0sirys/USAR_Drone_Feature/USAR_Drone_Feature.step

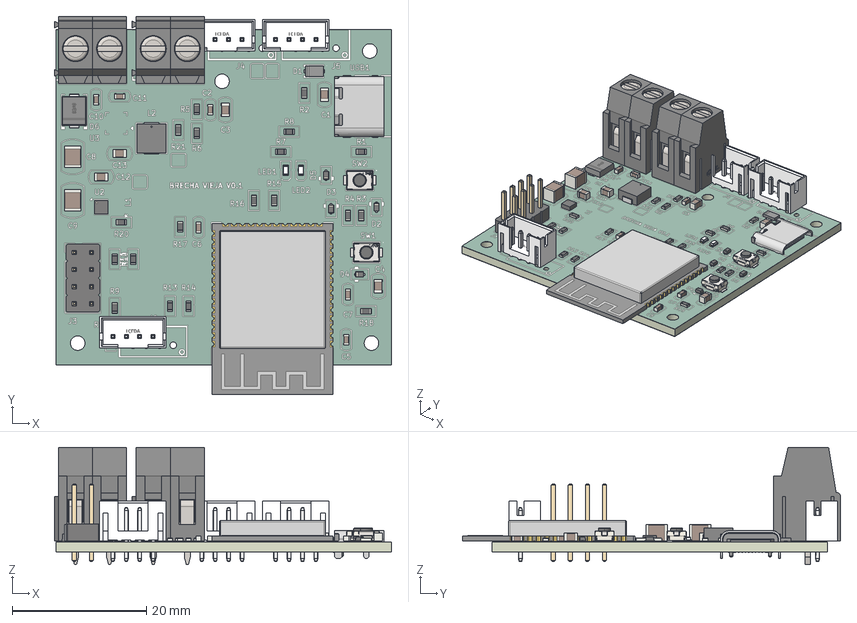
[picture p1: CAD file, 2026-07-15]
USAR_Drone_Feature.step
50.2 x 56.3 x 17.5 mm
CONN-TH_2P-P5.08_DB128L-5.08-2P-BK-S x 2
R_0603_1608Metric x 20
USB-C-SMD_TYPE-C-6PIN-2MD-073
C_1210_3225Metric x 2
C_0805_2012Metric x 5
SMB_L4.32-W3.62-LS5.3-RD
C_0603_1608Metric x 6
SW-SMD_L3.9-W2.9-H2.0-LS4.8 x 2
SOD-123_L2.7-W1.6-LS3.7-FD
PH2.0-LI-4P x 3
WIRELM-SMD_ESP32-S3-WROOM-1
PinHeader_2x04_P254mm_Vertical
LED0603-RD_RED x 2
WSON_8_1EP_2x2mm_P05mm_EP09x16mm
D_SOD_523 x 4
USAR_Drone_Feature_silkscreen
USAR_Drone_Feature_soldermask x 2
USAR_Drone_Feature_PCB
