0sirys/USAR_Drone_Feature/(list of files, cad)

Other CAD files:
.step
