0sirys/USAR_Drone_Feature/USAR_Drone_Feature.kicad_pcb

## KiCad design USAR_Drone_Feature.kicad_pcb (2026-08-30)

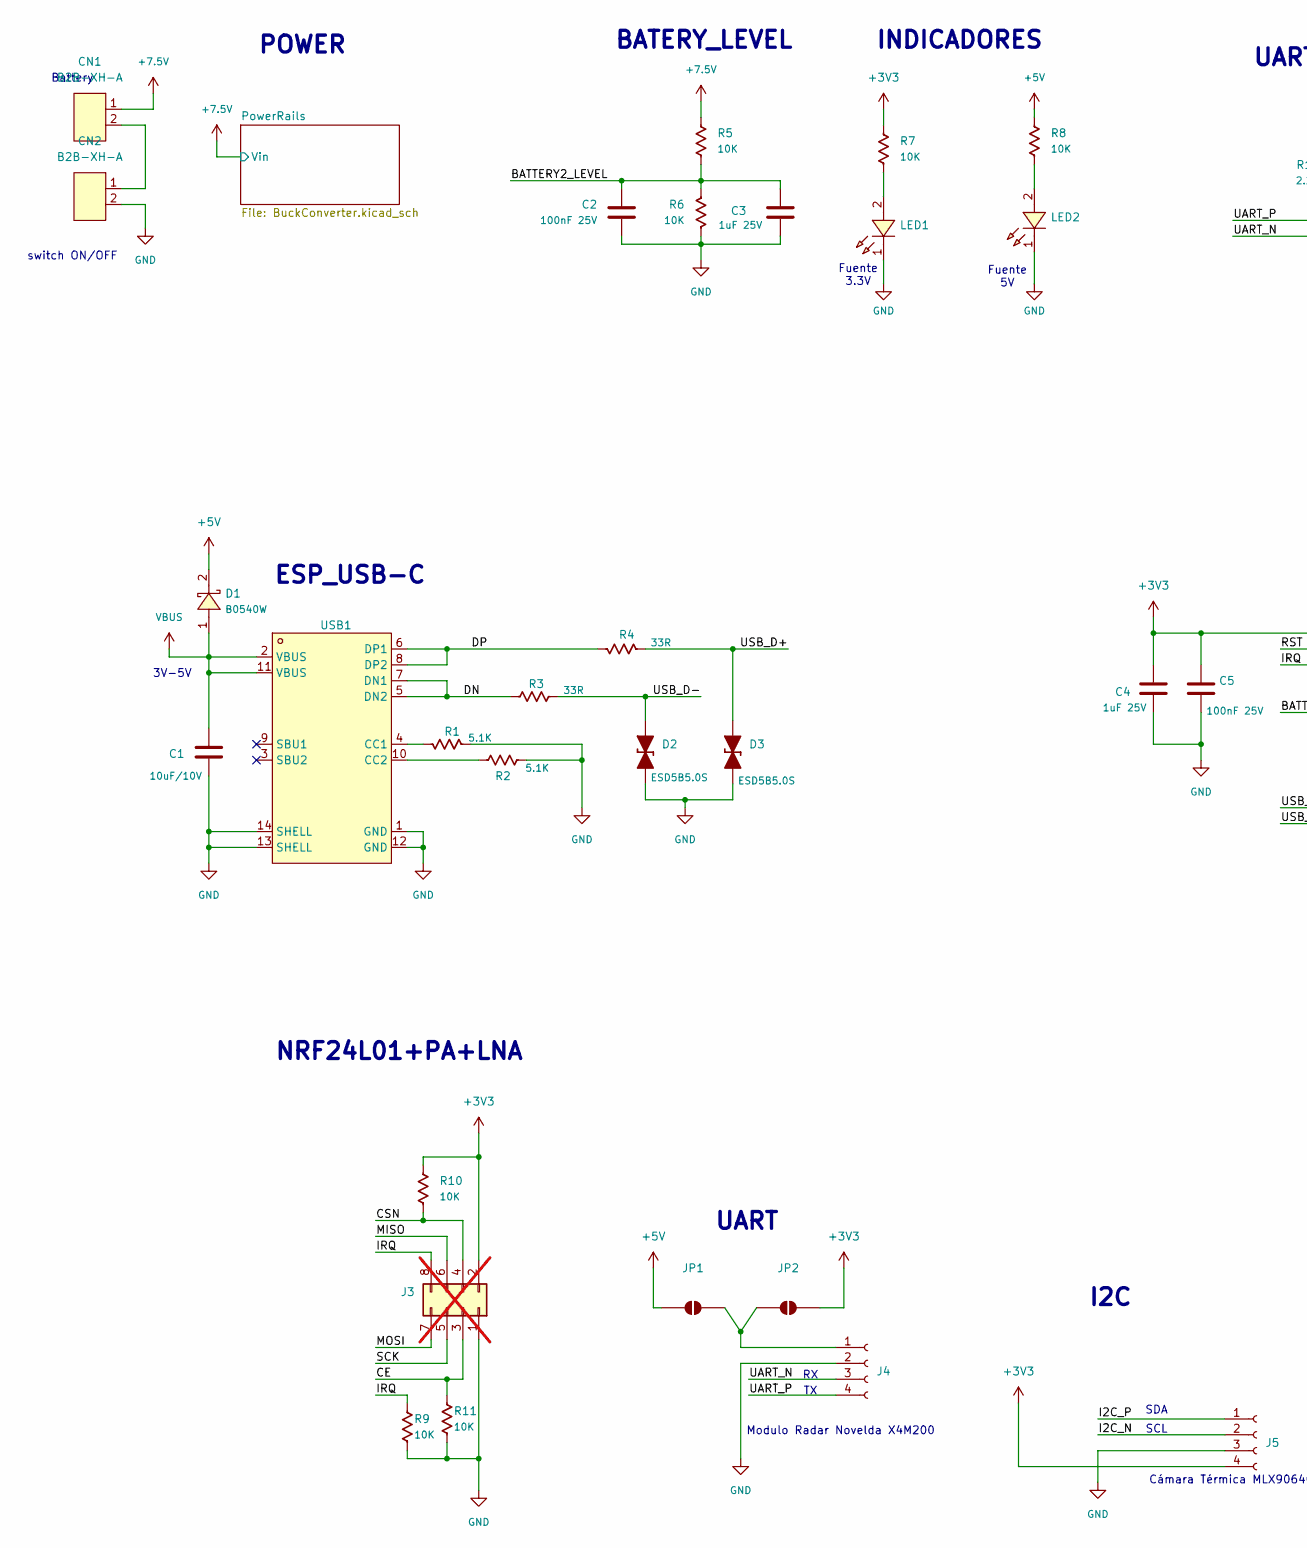
[picture p2: schematic USAR_Drone_Feature.kicad_sch, USARQ, part in row 1, column 1]

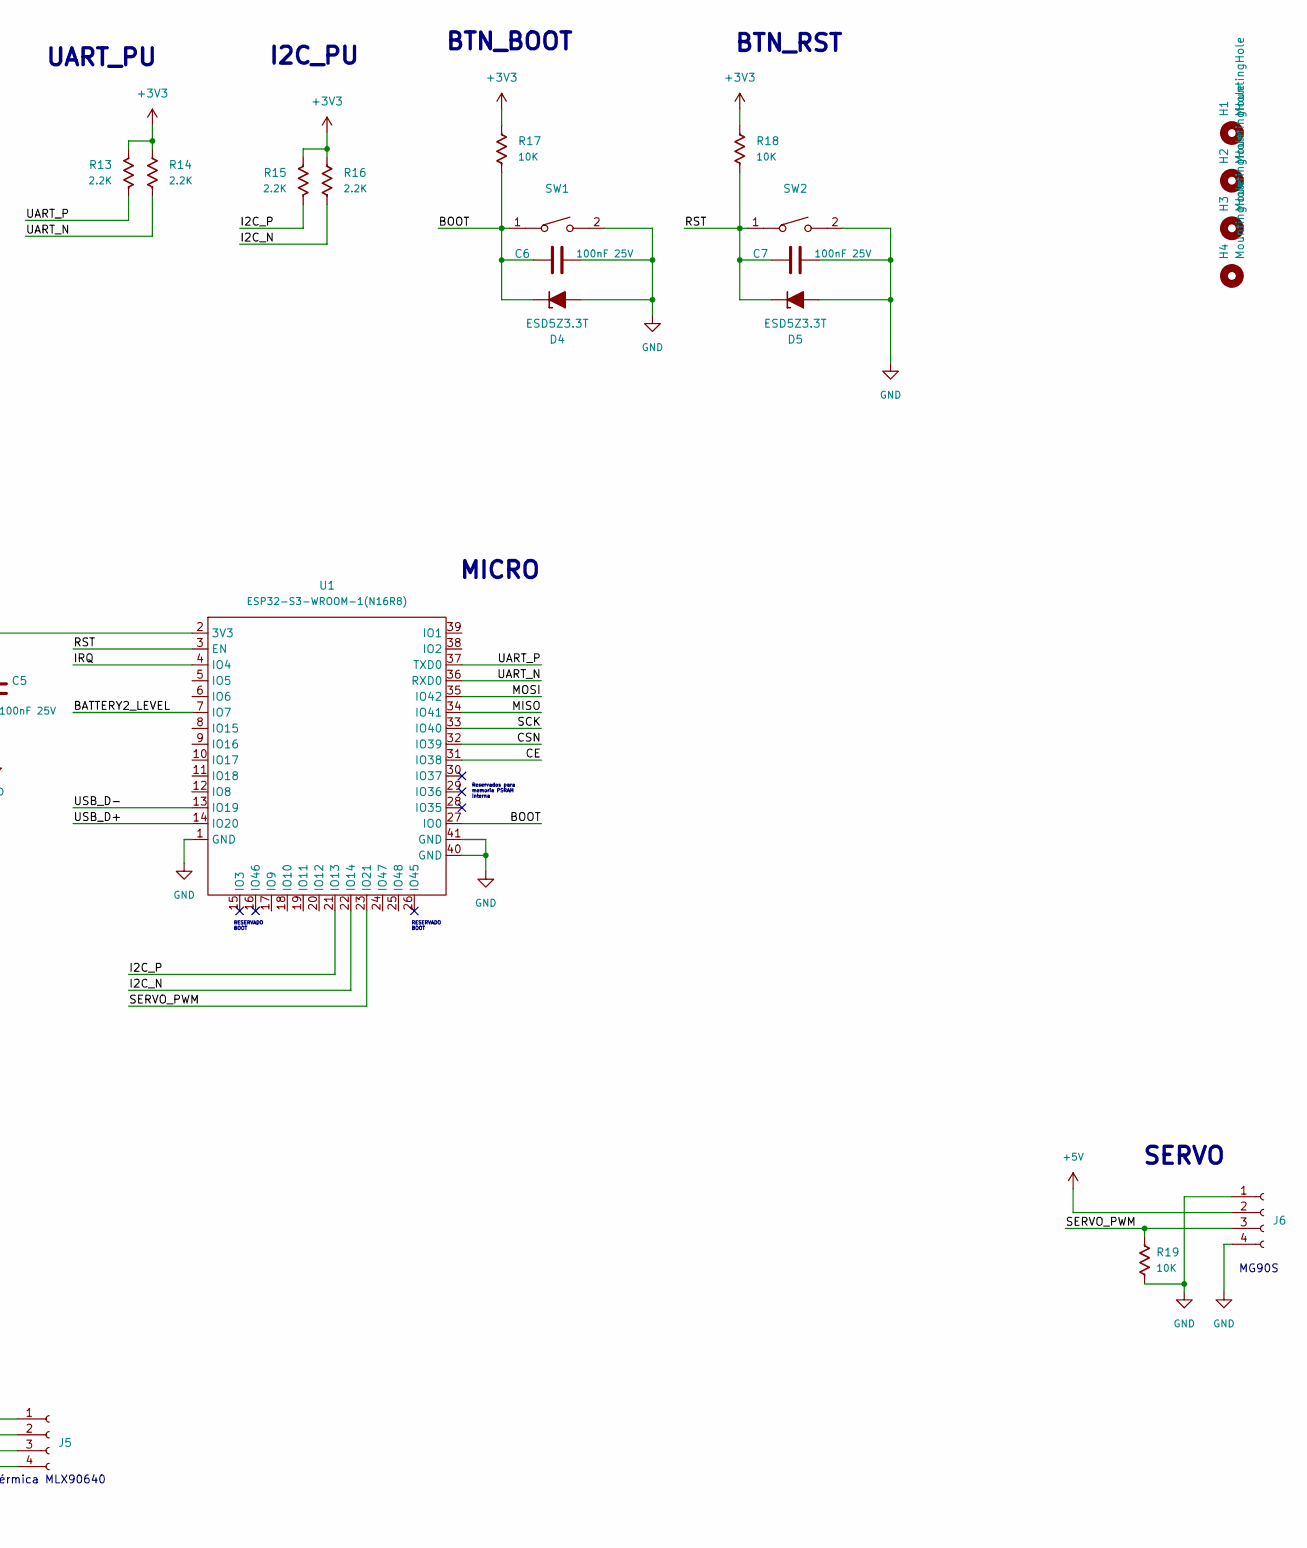
[picture p3: schematic USAR_Drone_Feature.kicad_sch, USARQ, part in row 1, column 2]

Parts:
C1: 10uF/10V; C_0805_2012Metric; LCSC Part C326595
C2, C5, C6, C7: 100nF 25V; C_0603_1608Metric; LCSC Part C14663
C3, C4: 1uF 25V; C_0805_2012Metric; LCSC Part 5370002
CN1, CN2: B2B-XH-A; CONN-TH_B2B-XH-A-LF-SN; MPN B2B-XH-A(LF)(SN); LCSC Part C158012
D1: B0540W; SOD-123_L2.7-W1.6-LS3.7-FD; MPN B0540W; LCSC Part C7420325
D2, D3: ESD5B5.0S; D_SOD-523; LCSC Part C2936975
D4, D5: ESD5Z3.3T; D_SOD-523; LCSC Part C61148
H1, H2, H3, H4: MountingHole; MountingHole_2.5mm
J3: Conn_02x04_Odd_Even; PinHeader_2x04_P2.54mm_Vertical; not fitted
J4, J5, J6: Conn_01x04_Socket; CONN-TH_B4B-PH-K-S; LCSC Part C144395
JP1, JP2: SolderJumper_2_Open; Jumper_2_NO
LED1, LED2: XL-1608SURC-06; LED0603-RD_RED; MPN XL-1608SURC-06; LCSC Part C965799
R1, R2: 5.1K; R_0603_1608Metric; LCSC Part C125891
R3, R4: 33R; R_0603_1608Metric; LCSC Part C108407
R5, R6, R7, R8, R9, R10, R11, R17, R18, R19: 10K; R_0603_1608Metric; LCSC Part C860067
R13, R14, R15, R16: 2.2K; R_0603_1608Metric; LCSC Part C113303
SW1, SW2: TS-1088-AR02016; SW-SMD_L3.9-W3.0-P4.45; MPN TS-1088-AR02016; LCSC Part C720477
U1: ESP32-S3-WROOM-1(N16R8); WIRELM-SMD_ESP32-S3-WROOM-1; LCSC Part C2913202
USB1: TYPE-C 16PIN 2MD; USB-C-SMD_TYPE-C-6PIN-2MD-073; MPN TYPE-C 16PIN 2MD(073); LCSC Part C2765186

Connections:
+3V3: C4.1, C5.1, J3.2, J5.4, JP2.2 (B), R7.1, R10.1, R13.1, R14.1, R15.1, R16.1, R17.1, R18.1, U1.2 (3V3); also elsewhere on the board
+5V: D1.2, J6.2, JP1.1 (A), R8.1; also elsewhere on the board
+7.5V: CN1.1, R5.1; also elsewhere on the board
/BATTERY2_LEVEL: C2.1, C3.1, R5.2, R6.1, U1.7 (IO7)
/BOOT: C6.1, D4.1 (K), R17.2, SW1.1, U1.27 (IO0)
/CE: J3.3, R11.1, U1.31 (IO38)
/CSN: J3.4, R10.2, U1.32 (IO39)
/DN: R3.1, USB1.5 (DN2), USB1.7 (DN1)
/DP: R4.1, USB1.6 (DP1), USB1.8 (DP2)
/I2C_N: J5.2, R16.2, U1.22 (IO14)
/I2C_P: J5.1, R15.2, U1.21 (IO13)
/IRQ: J3.8, R9.1, U1.4 (IO4)
/MISO: J3.6, U1.34 (IO41)
/MOSI: J3.7, U1.35 (IO42)
/RST: C7.1, D5.1 (K), R18.2, SW2.1, U1.3 (EN)
/SCK: J3.5, U1.33 (IO40)
/SERVO_PWM: J6.3, R19.1, U1.23 (IO21)
/UART_N: J4.3, R14.2, U1.36 (RXD0)
/UART_P: J4.4, R13.2, U1.37 (TXD0)
/USB_D+: D3.2 (A), R4.2, U1.14 (IO20)
/USB_D-: D2.2 (A), R3.2, U1.13 (IO19)
GND: C1.2, C2.2, C3.2, C4.2, C5.2, C6.2, C7.2, CN2.2, D2.1 (K), D3.1 (K), D4.2 (A), D5.2 (A), J3.1, J4.2, J5.3, J6.1, J6.4, LED1.1, LED2.1, R1.2, R2.2, R6.2, R9.2, R11.2, R19.2, SW1.2, SW2.2, U1.1 (GND), U1.40 (GND), U1.41 (GND), USB1.1 (GND), USB1.12 (GND), USB1.13 (SHELL), USB1.14 (SHELL); also elsewhere on the board
unnamed: CN1.2, CN2.1
unnamed: J4.1, JP1.2 (B), JP2.1 (A)
unnamed: LED1.2, R7.2
unnamed: LED2.2, R8.2
unnamed: R1.1, USB1.4 (CC1)
unnamed: R2.1, USB1.10 (CC2)
VBUS: C1.1, D1.1, USB1.2 (VBUS), USB1.11 (VBUS)

Notes on the sheet:
MICRO
Fuente 3.3V
POWER
BATERY_LEVEL
SDA
MG90S
RESERVADO BOOT
SERVO
NRF24L01+PA+LNA
SCL
Battery
INDICADORES
BTN_BOOT
Cámara Térmica MLX90640
Modulo Radar Novelda X4M200
ESP_USB-C
I2C_PU
I2C
BTN_RST
UART
switch ON/OFF
Reservados para memoria PSRAM Interna
UART_PU
Fuente 5V
3V-5V

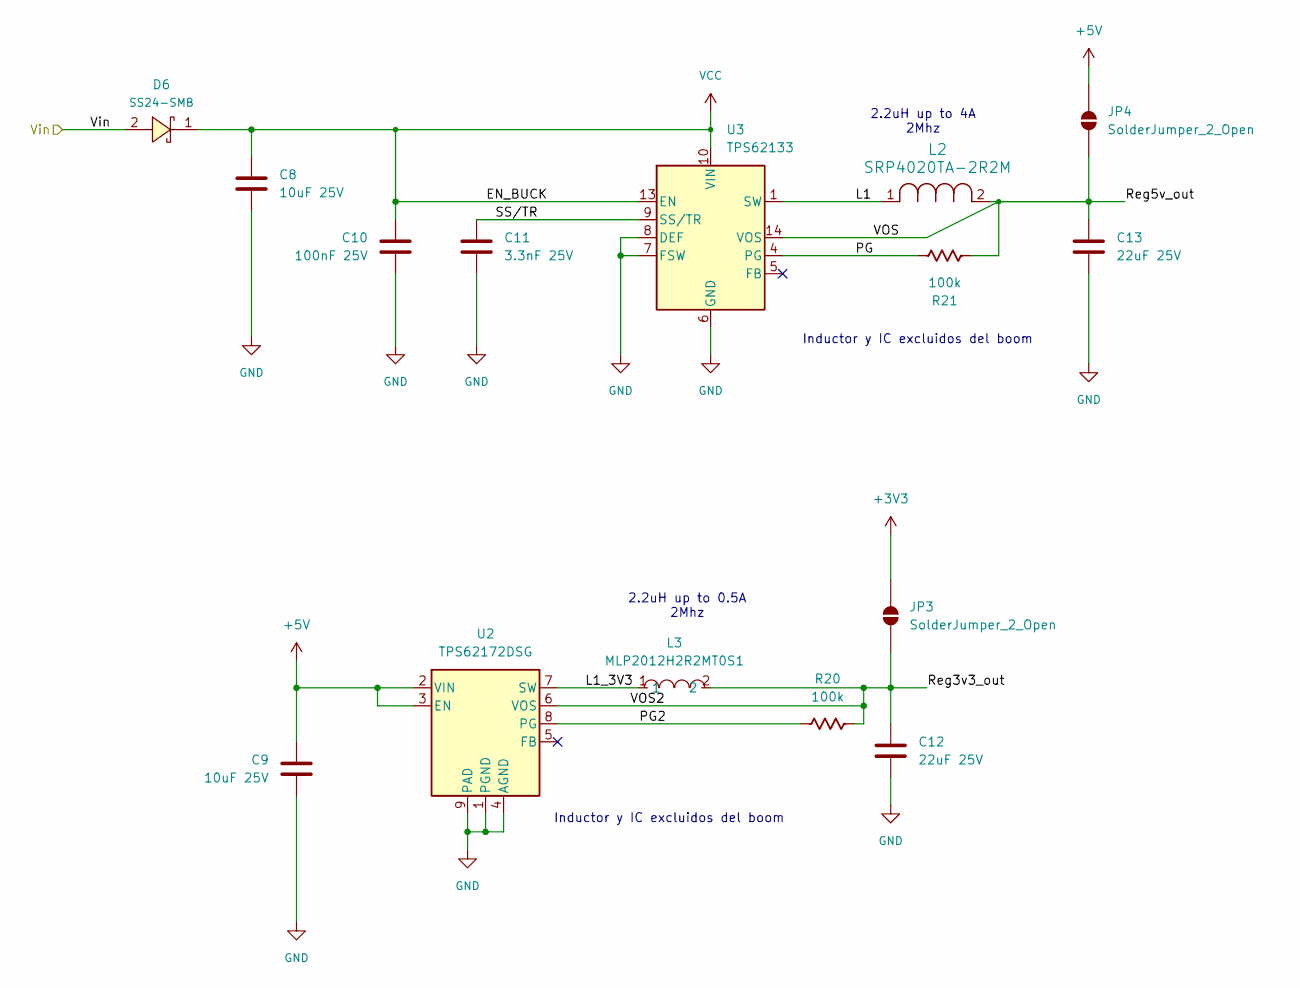
[picture p4: schematic BuckConverter.kicad_sch]

Parts:
C8, C9: 10uF 25V; C_1210_3225Metric; LCSC Part C577292
C10: 100nF 25V; C_0603_1608Metric; LCSC Part C14663
C11: 3.3nF 25V; C_0603_1608Metric; LCSC Part C107088
C12, C13: 22uF 25V; C_0805_2012Metric; LCSC Part C602037
D6: SS24-SMB; SMB_L4.3-W3.6-LS5.3-RD; MPN SS24-SMB; LCSC Part C908683
JP3, JP4: SolderJumper_2_Open; Jumper_2_NO
L2: SRP4020TA-2R2M; IND_SRP4020TA_BRN-L
L3: MLP2012H2R2MT0S1; L0805; MPN MLP2012H2R2MT0S1; LCSC Part C383369
R20, R21: 100k; R_0603_1608Metric; LCSC Part C122538
U2: TPS62172DSG; WSON-8-1EP_2x2mm_P0.5mm_EP0.9x1.6mm_ThermalVias
U3: TPS62133; VQFN-16-1EP_3x3mm_P0.5mm_EP1.68x1.68mm_ThermalVias

Connections:
+3V3: JP3.2 (B); also elsewhere on the board
+5V: C9.1, JP4.2 (B), U2.2 (VIN), U2.3 (EN); also elsewhere on the board
+7.5V: D6.2; also elsewhere on the board
/PowerRails/L1: L2.1, U3.1 (SW), U3.2 (SW), U3.3 (SW)
/PowerRails/L1_3V3: L3.1, U2.7 (SW)
/PowerRails/PG: R21.2, U3.4 (PG)
/PowerRails/PG2: R20.1, U2.8 (PG)
/PowerRails/Reg3v3_out: C12.1, JP3.1 (A), L3.2, R20.2, U2.6 (VOS)
/PowerRails/Reg5v_out: C13.1, JP4.1 (A), L2.2, R21.1, U3.14 (VOS)
/PowerRails/SS/TR: C11.2, U3.9 (SS/TR)
GND: C8.2, C9.2, C10.1, C11.1, C12.2, C13.2, U2.1 (PGND), U2.4 (AGND), U2.9 (PAD), U3.6 (GND), U3.7 (FSW), U3.8 (DEF), U3.15 (GND), U3.16 (GND), U3.17 (GND); also elsewhere on the board
VCC: C8.1, C10.2, D6.1, U3.10 (VIN), U3.11 (VIN), U3.12 (VIN), U3.13 (EN)

Notes on the sheet:
2.2uH up to 0.5A 2Mhz
Inductor y IC excluidos del boom
2.2uH up to 4A 2Mhz

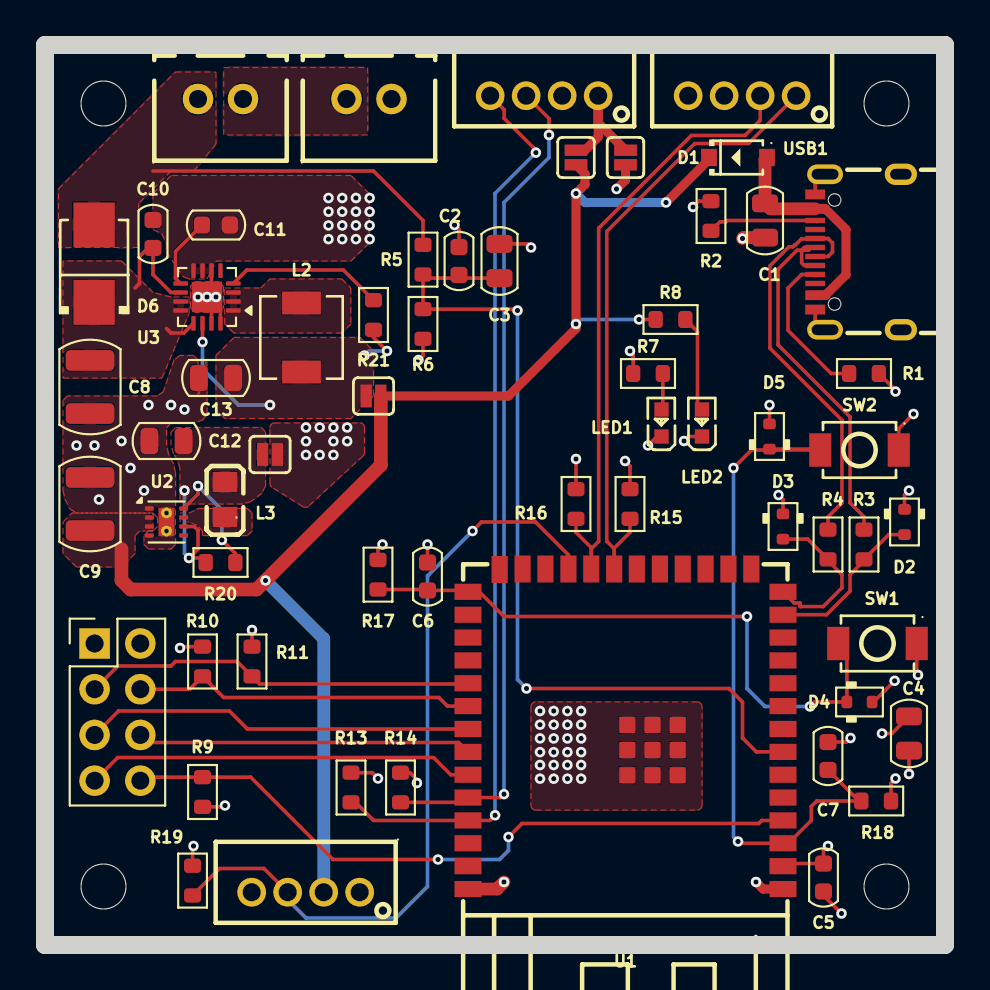
[picture p5: board USAR_Drone_Feature.kicad_pcb from above]

Board: 4 copper layers, 50.0 x 50.0 mm, 63 parts (0 on the bottom side), 37 nets.
