0sirys/USAR_Drone_Feature/RC_Car.kicad_pcb

## KiCad design RC_Car.kicad_pcb (2026-06-17)

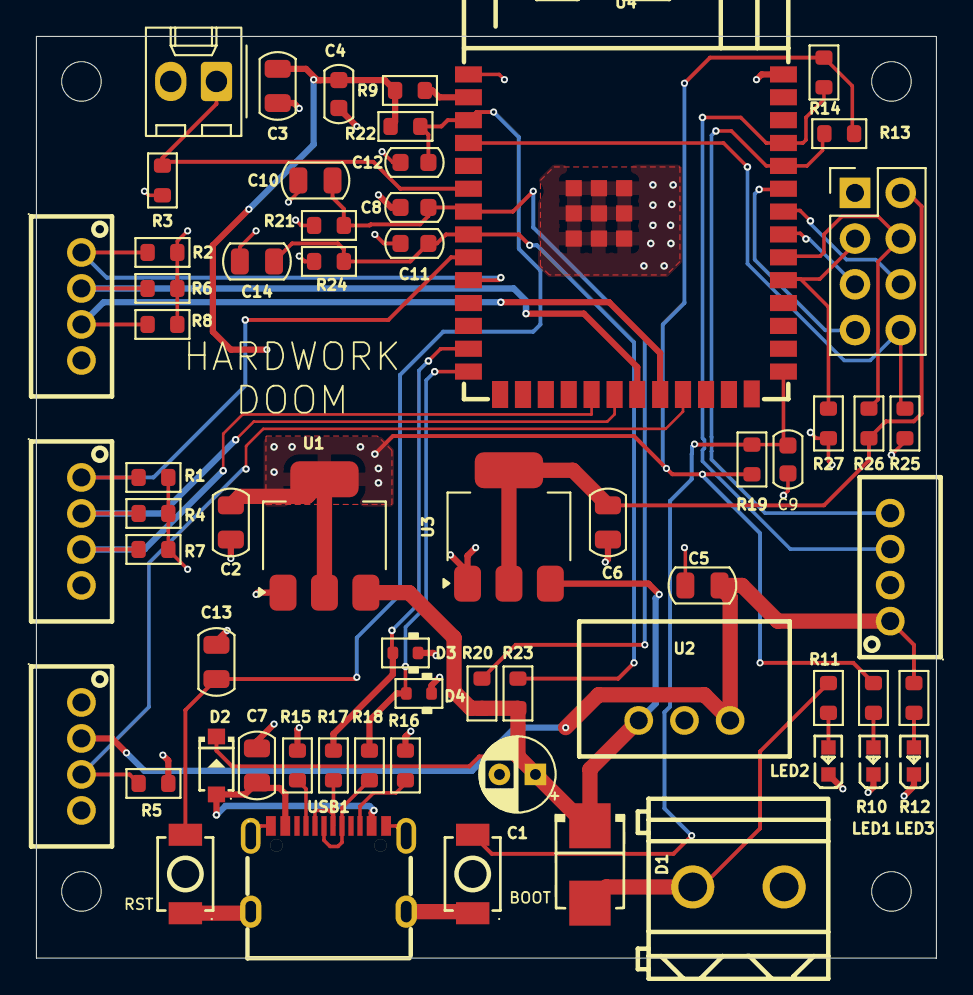
[picture p6: board RC_Car.kicad_pcb from above]

Board: 2 copper layers, 50.0 x 51.2 mm, 66 parts (0 on the bottom side), 37 nets.

Parts:
C1: 100uF; CP_Radial_D4.0mm_P2.00mm
C2, C5, C6, C7: 10uF/10V; C_0805_2012Metric
C3, C10, C13: 1uF/10V; C_0805_2012Metric
C4, C8, C9, C11, C12: 0.1uF/10V; C_0603_1608Metric
C14: 1uF; C_0805_2012Metric
D1: SS24-SMB; SMB_L4.3-W3.6-LS5.3-RD
D2: B0540W; SOD-123_L2.7-W1.6-LS3.7-FD
D3, D4: ESD5B5.0S; D_SOD-523
H1, H2, H3, H4: MountingHole; MountingHole_2.2mm_M2_DIN965
J1: DB128L-5.08-2P-BK-S; CONN-TH_2P-P5.08_DB128L-5.08-2P-BK-S
J2: Conn_01x02_Socket; Molex_KK-254_AE-6410-02A_1x02_P2.54mm_Vertical
J3, J4, J5, J6: Conn_01x04_Socket; CONN-TH_B4B-PH-K-S
J7: Conn_02x04_Odd_Even; PinHeader_2x04_P2.54mm_Vertical
LED1, LED2, LED3: XL-1608SURC-06; LED0603-RD_RED
R1, R2, R3, R4, R5, R6, R7, R8, R10, R11, R12, R19, R20, R21, R22, R23, R24, R25, R26, R27: 10K; R_0603_1608Metric
R9: 0(1%); R_0603_1608Metric
R13, R14: 2.2K; R_0603_1608Metric
R15, R16: 5.1K; R_0603_1608Metric
R17, R18: 33R; R_0603_1608Metric
SW1, SW2: TS-1088-AR02016; SW-SMD_L3.9-W3.0-P4.45
U1, U3: AMS1117-3.3; SOT-223-3_TabPin2
U2: TSR 1-2450_C6886877; PWRM-TH_L11.7-W7.5_TSR1-2450
U4: ESP32-S3-WROOM-1(N16R8); WIRELM-SMD_ESP32-S3-WROOM-1
USB1: TYPE-C 16PIN 2MD; USB-C-SMD_TYPE-C-6PIN-2MD-073

Connections:
+3.3V: C2.1, C3.1, C4.1, R9.1, R10.1, R13.1, R14.1, R19.1, R22.1, U1.2 (VO)
+3.3V_RF: C6.1, J7.2, R26.1, U3.2 (VO)
+5V: C5.1, J4.2, J6.1, R12.1, U2.3 (+Vout)
+7.5V: D1.2, J1.1, R11.1
/BATTERY1_LEVEL: C11.1, C14.1, R23.2, R24.1, U4.8 (IO15)
/BATTERY2_LEVEL: C8.1, C10.1, R20.2, R21.1, U4.7 (IO7)
/BOOT: C9.1, R19.2, SW1.1, U4.27 (IO0)
/CE: J7.3, R27.1, U4.31 (IO38)
/CSN: J7.4, R26.2, U4.32 (IO39)
/IRQ: J7.8, R25.1, U4.4 (IO4)
/M1_DIR_L: J3.2, R4.1, U4.20 (IO12)
/M1_DIR_R: J3.3, R7.1, U4.19 (IO11)
/M1_PWM: J3.1, R1.1, U4.9 (IO16)
/M2_DIR_L: J5.2, R6.1, U4.21 (IO13)
/M2_DIR_R: J5.3, R8.1, U4.22 (IO14)
/M2_PWM: J5.1, R2.1, U4.10 (IO17)
/MISO: J7.6, U4.34 (IO41)
/MOSI: J7.7, U4.35 (IO42)
/OSD_PWM: J2.1, R3.1, U4.6 (IO6)
/RST: C12.1, C13.1, R22.2, SW2.1, U4.3 (EN)
/SCK: J7.5, U4.33 (IO40)
/SERVO_PWM: J4.3, R5.1, U4.23 (IO21)
/UART_RX0: J6.4, R13.2, U4.36 (RXD0)
/UART_TX0: J6.3, R14.2, U4.37 (TXD0)
/USB_D+: D4.2 (A), R18.2, U4.14 (IO20)
/USB_D-: D3.2 (A), R17.2, U4.13 (IO19)
ESP_3.3V: R9.2, U4.2 (3V3)
GND: C1.2, C2.2, C3.2, C4.2, C5.2, C6.2, C7.2, C8.2, C9.2, C10.2, C11.2, C12.2, C13.2, C14.2, D3.1 (K), D4.1 (K), J1.2, J2.2, J3.4, J4.1, J4.4, J5.4, J6.2, J7.1, LED1.1, LED2.1, LED3.1, R1.2, R2.2, R3.2, R4.2, R5.2, R6.2, R7.2, R8.2, R15.2, R16.2, R21.2, R24.2, R25.2, R27.2, SW1.2, SW2.2, U1.1 (GND), U2.2 (GND), U3.1 (GND), U4.1 (GND), U4.40 (GND), U4.41 (GND), USB1.1 (GND), USB1.12 (GND), USB1.13 (SHELL), USB1.14 (SHELL)
unnamed: LED1.2, R10.2
unnamed: LED2.2, R11.2
unnamed: LED3.2, R12.2
unnamed: R15.1, USB1.4 (CC1)
unnamed: R16.1, USB1.10 (CC2)
unnamed: R17.1, USB1.5 (DN2), USB1.7 (DN1)
unnamed: R18.1, USB1.6 (DP1), USB1.8 (DP2)
VBUS: C7.1, D2.1, USB1.2 (VBUS), USB1.11 (VBUS)
VCC: C1.1, D1.1, D2.2, R20.1, R23.1, U1.3 (VI), U2.1 (+Vin), U3.3 (VI)
