0sirys/USAR_Drone_Feature/(commit log)

2026-06-17 Primer commit
    [RC_Car.kicad_pcb, USAR_Drone_Feature.kicad_pcb, USAR_Drone_Feature.kicad_sch]
2026-07-09 Add Buck Converter Fixed 5V
    [BuckConverter.kicad_sch, USAR_Drone_Feature.kicad_pcb, USAR_Drone_Feature.kicad_sch]
2026-07-09 etiquetar cables
    [BuckConverter.kicad_sch, USAR_Drone_Feature.kicad_sch]
2026-07-09 add LDO 3v3, change buckconverter sheet to Power Rails
    [BuckConverter.kicad_sch, USAR_Drone_Feature.kicad_sch]
2026-07-09 modificacion general de esquematico
    [BuckConverter.kicad_sch, USAR_Drone_Feature.kicad_sch]
2026-07-10 asignacion de huellas, valores y lcsc part #, dejar de rastrear .history/
    [BuckConverter.kicad_sch, USAR_Drone_Feature.kicad_sch]
2026-07-11 pcb desing done, add productions files
    [.step, BuckConverter.kicad_sch, USAR_Drone_Feature.kicad_pcb, USAR_Drone_Feature.kicad_sch, bom.csv, designators.csv, positions.csv]
2026-07-15 ajuste de agujeros
    [USAR_Drone_Feature.kicad_pcb, USAR_Drone_Feature.kicad_sch, USAR_Drone_Feature.step]
2026-07-15 ajuste de footprints, reposicionamiento de agujeros
    [USAR_Drone_Feature.kicad_pcb, USAR_Drone_Feature.kicad_sch]
2026-07-15 ajuste faltante
    [USAR_Drone_Feature.kicad_pcb]
2026-07-15 cambio agujeros 2.2mm a 2.5mm
    [USAR_Drone_Feature.kicad_pcb, USAR_Drone_Feature.kicad_sch, bom.csv, designators.csv, positions.csv]
2026-08-03 cambiar bobina de power suppy
    [BuckConverter.kicad_sch, PFV1MM3_bom.csv, PFV1MM3_designators.csv, PFV1MM3_positions.csv, USAR_Drone_Feature.kicad_pcb, USAR_Drone_Feature.kicad_sch]
2026-08-13 ajustes finales
    [PWFV0.1_bom.csv, PWFV0.1_designators.csv, PWFV0.1_positions.csv, USAR_Drone_Feature.kicad_pcb]
